Jrodna/OrthoCode/README.md

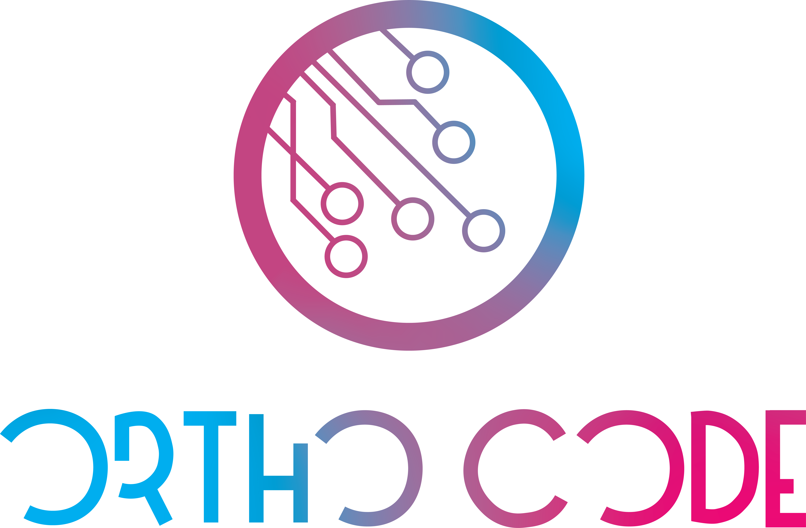
[picture p1: images/Logo_full.png]
Orthocode


Custom keyboard designed by me
The aim was to create a layout that would take advantage of what your thumbs can do to help with ergonomics.
While also keeping compatibility with the controls of most games and allowing standard keycaps to be used.

## The store is now closed
**Sold out as of 24/06/24**

If you build your own I'd love to see it, please send through photos to orthocodekb@gmail.com :)

~~There are still some units for sale, if you would like to purchase one for NZD 280 + shipping please contact me directly at orthocodekb@gmail.com
Happy to discuss doing the build for you / soldering some components before sending it out at no additional cost.~~

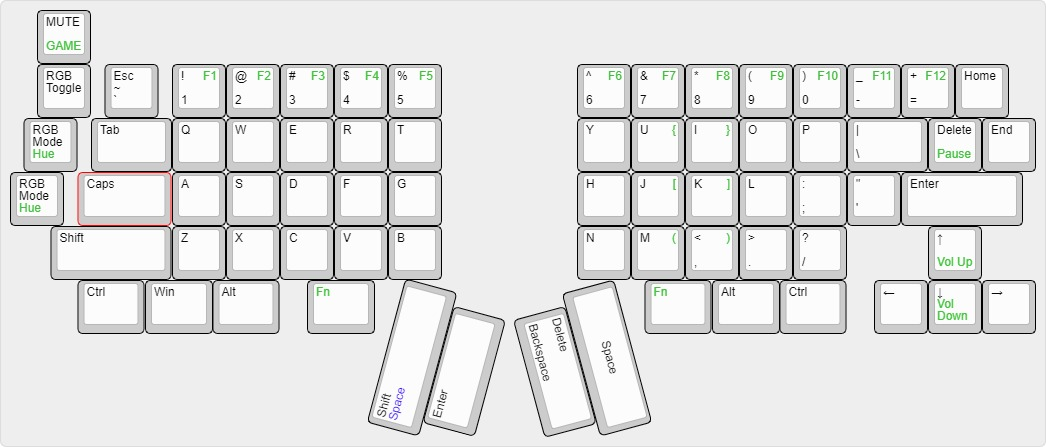
[picture p2: images/keyboard-layout.jpg]
Layout Image


# Version 1.0
- Larger footprints for resistors
- Added second plate option
- Plate now extends to edge of case
- Case updated to have even thickness either side of screws

# [Build Guide](https://docs.google.com/document/d/1nWpPh-oH03j4JtJZUHaI0wIrHX6gjucpwuYNbipHhU0/edit?usp=sharing)
# [Flashing Guide](https://docs.google.com/document/d/1nAf7OWkI6dcUZ9Cg3KUXB8WHUz0CQ5AS2SiLe1XIzos/edit?usp=sharing)

# PCB
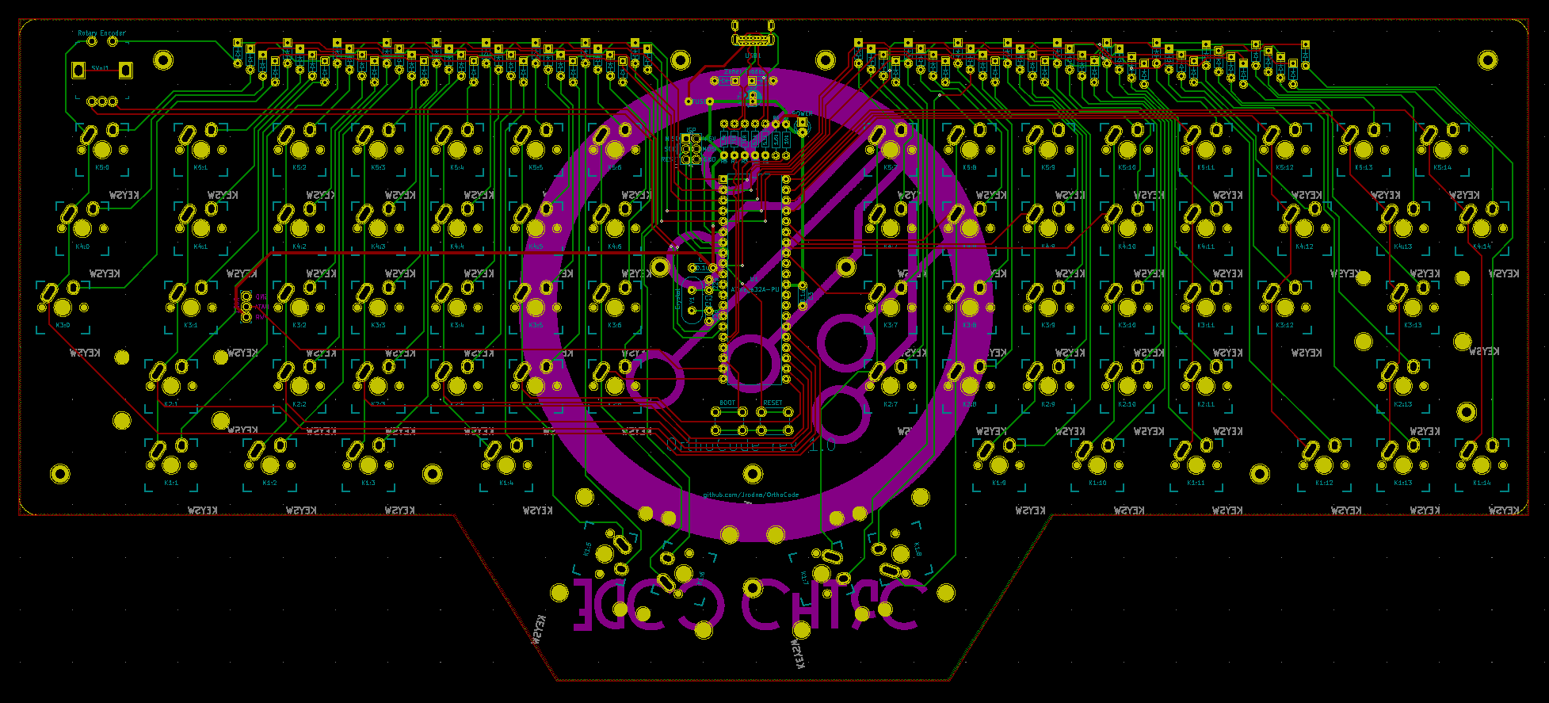
[picture p3: images/1.0 PCB.PNG]
PCB Image


# BOM
[Octopart parts list](https://octopart.com/bom-tool/VurG2dVY)

# Production Photos
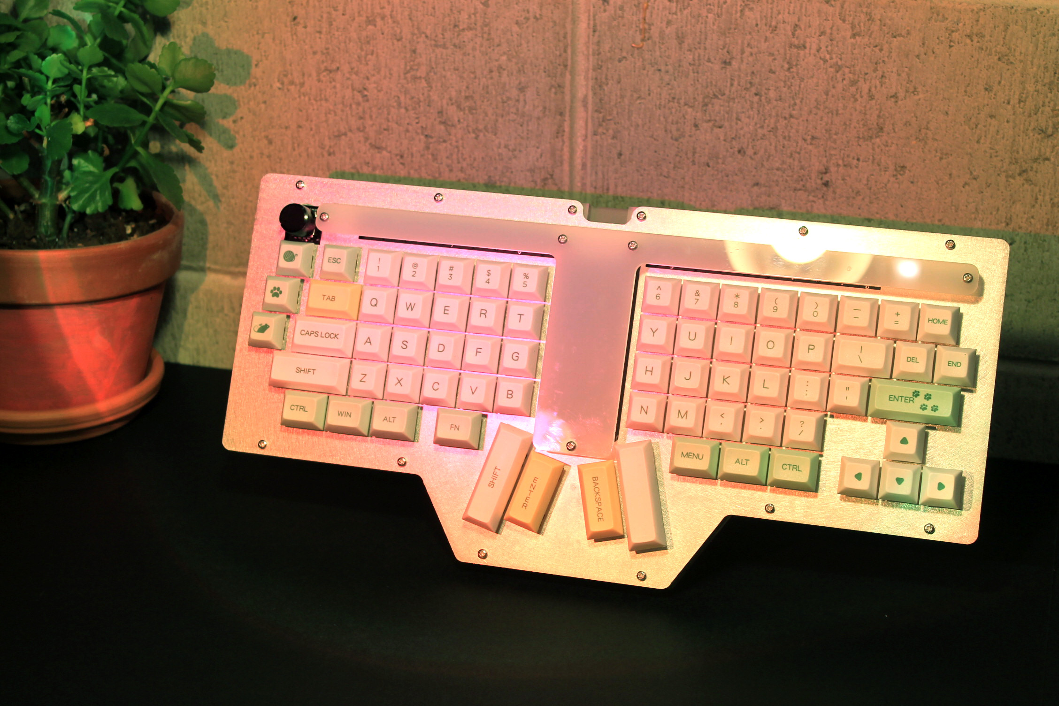
[picture p4: images/IMG_5573.JPG]

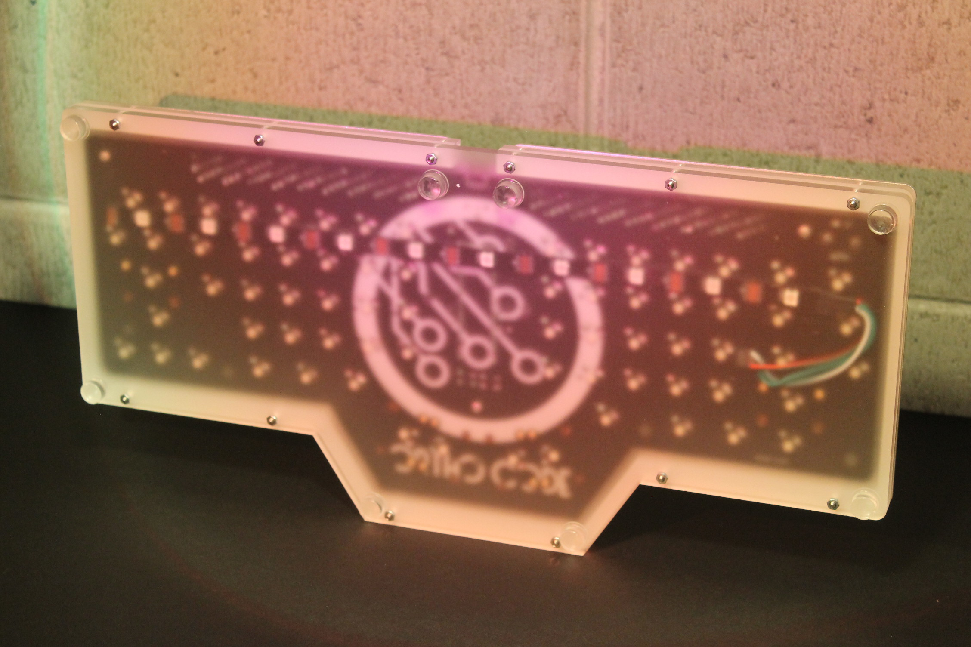
[picture p5: images/IMG_5571.JPG]

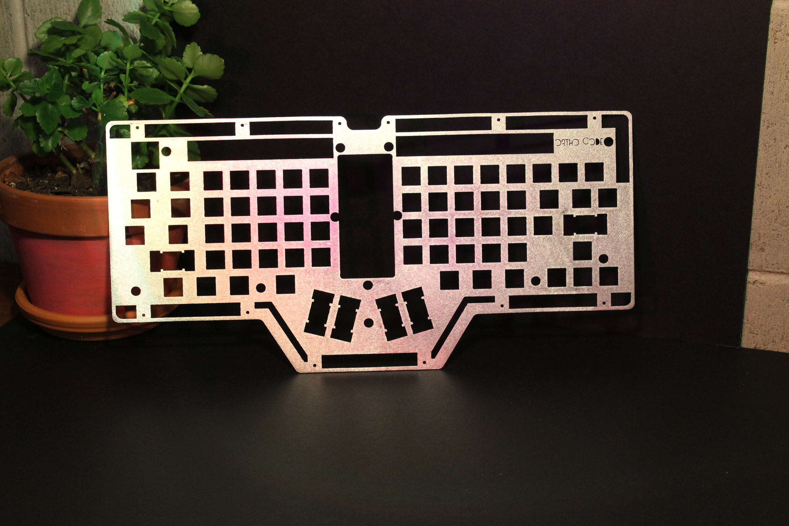
[picture p6: images/IMG_5576.png]

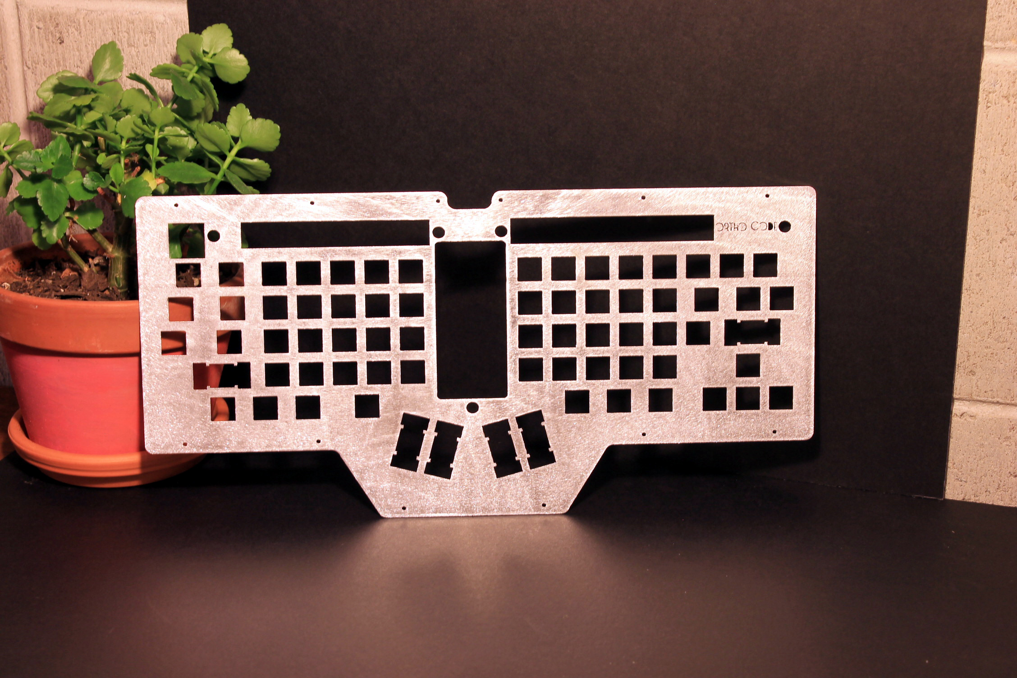
[picture p7: images/IMG_5580.JPG]

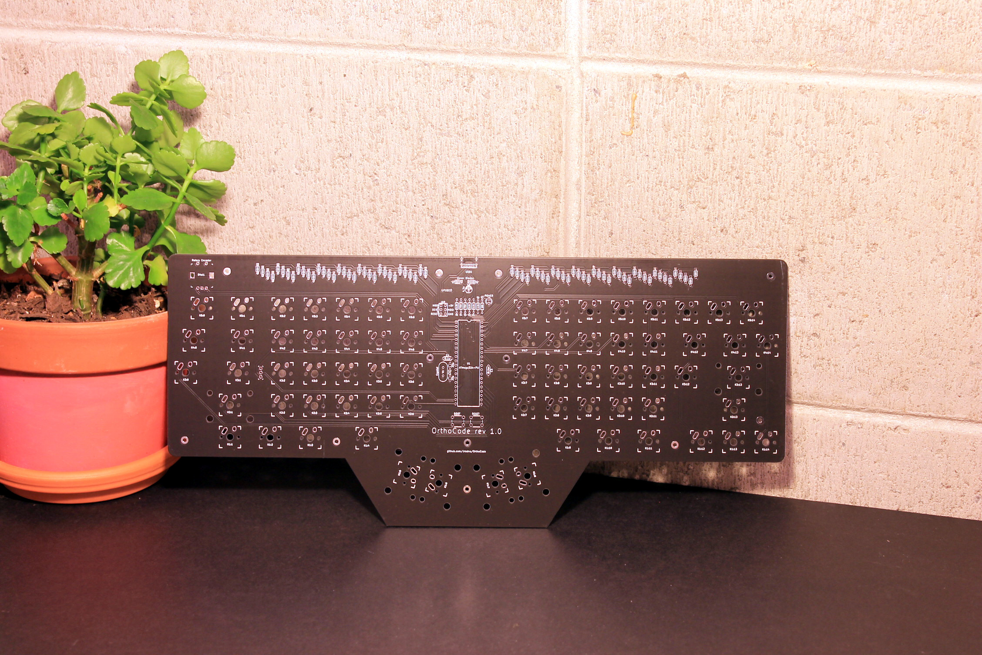
[picture p8: images/IMG_5581.JPG]

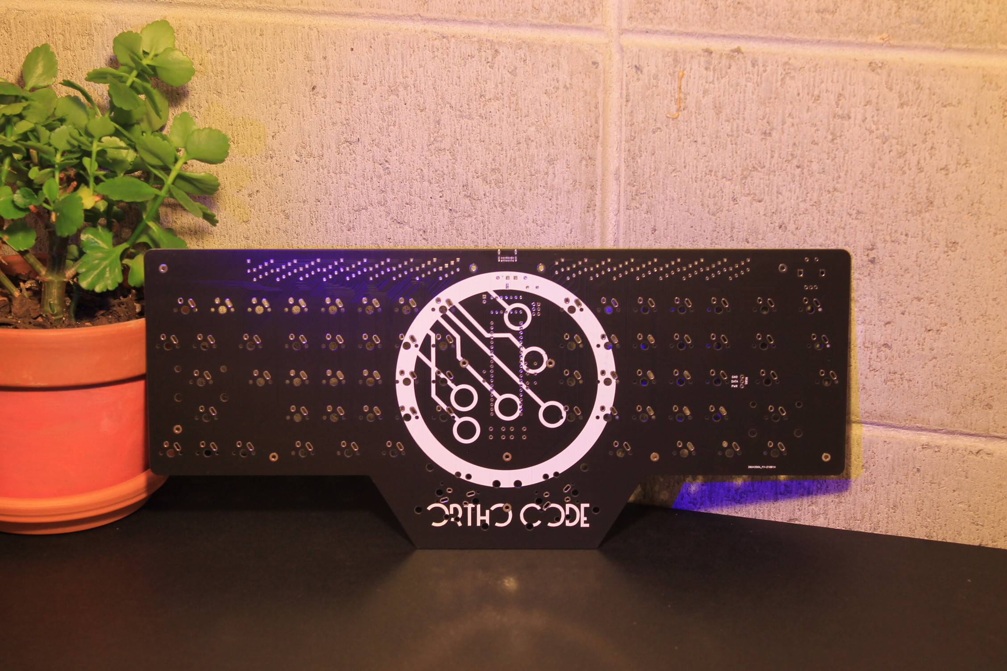
[picture p9: images/IMG_5586.JPG]

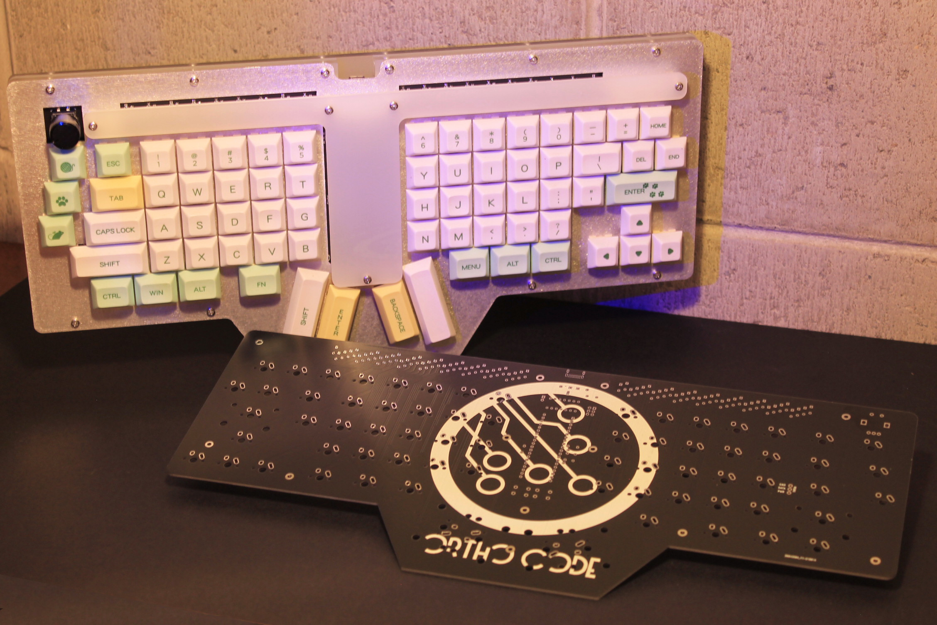
[picture p10: images/IMG_5587.JPG]

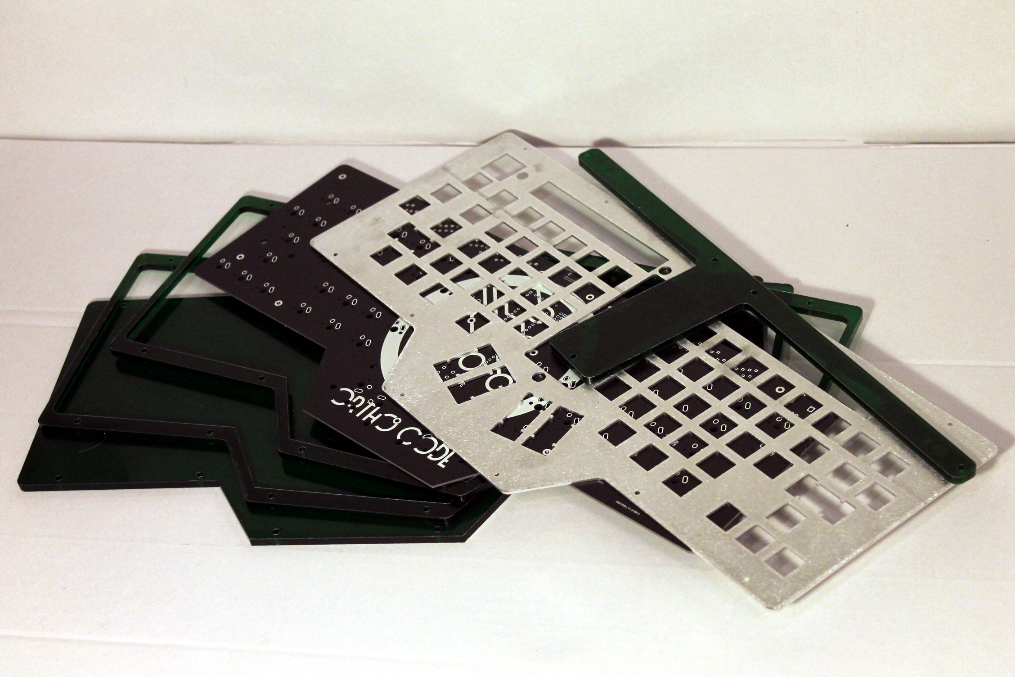
[picture p11: images/IMG_5604.JPG]


# Sound Test

video: https://www.youtube.com/embed/ZMxaZsce7TQ

Files for laser cutting at:
https://github.com/Jrodna/OrthoCode/tree/master/laserFiles

Acrylic sizes
Middle layers: any number of pieces making up 9mm in thickness (production ones were either 2x4.5mm or 6mm and 3mm)
Base layer: any thickness (production ones were either 6mm or 4.5mm)
