Jrodna/OrthoCode/images/0.jpg

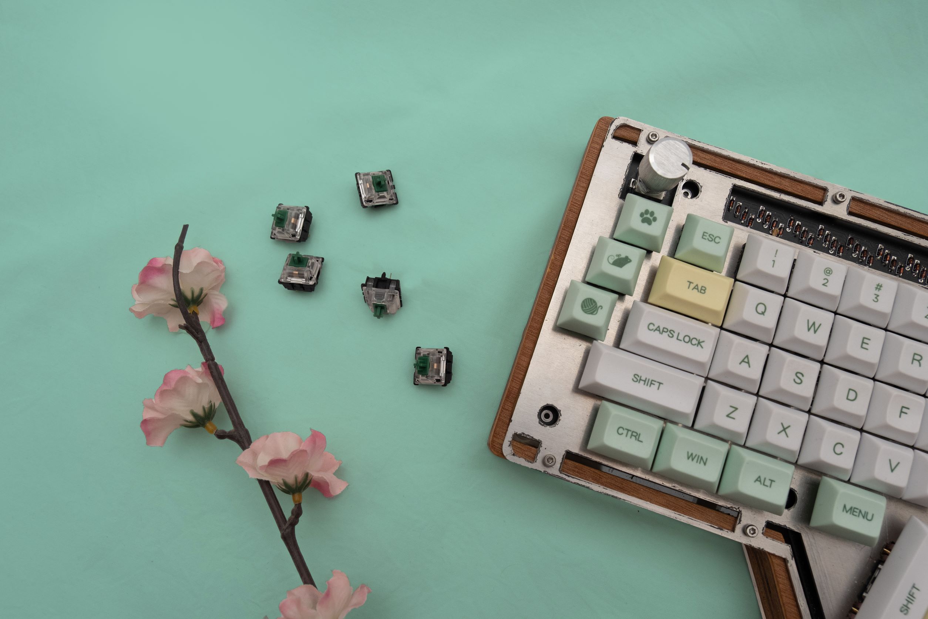
images/0.jpg
