Jrodna/OrthoCode/images/1.jpg

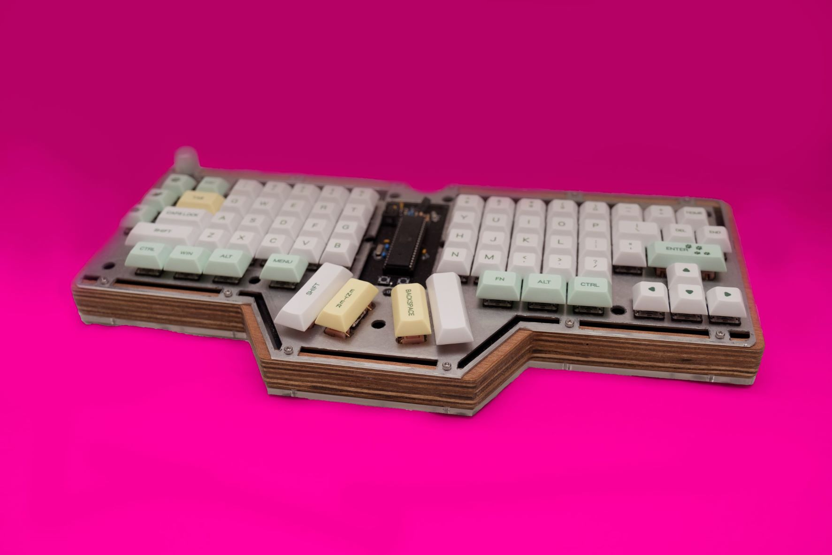
images/1.jpg
