Jrodna/OrthoCode/images/2.jpg

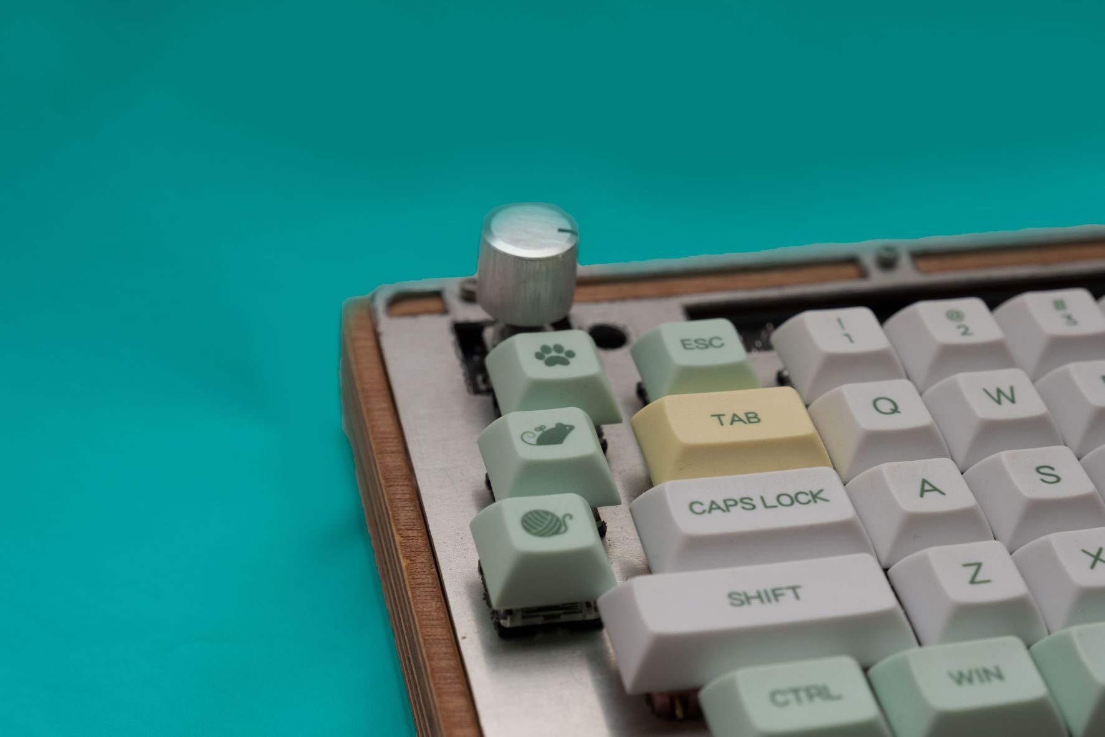
images/2.jpg
