Jrodna/OrthoCode/images/3dView.png

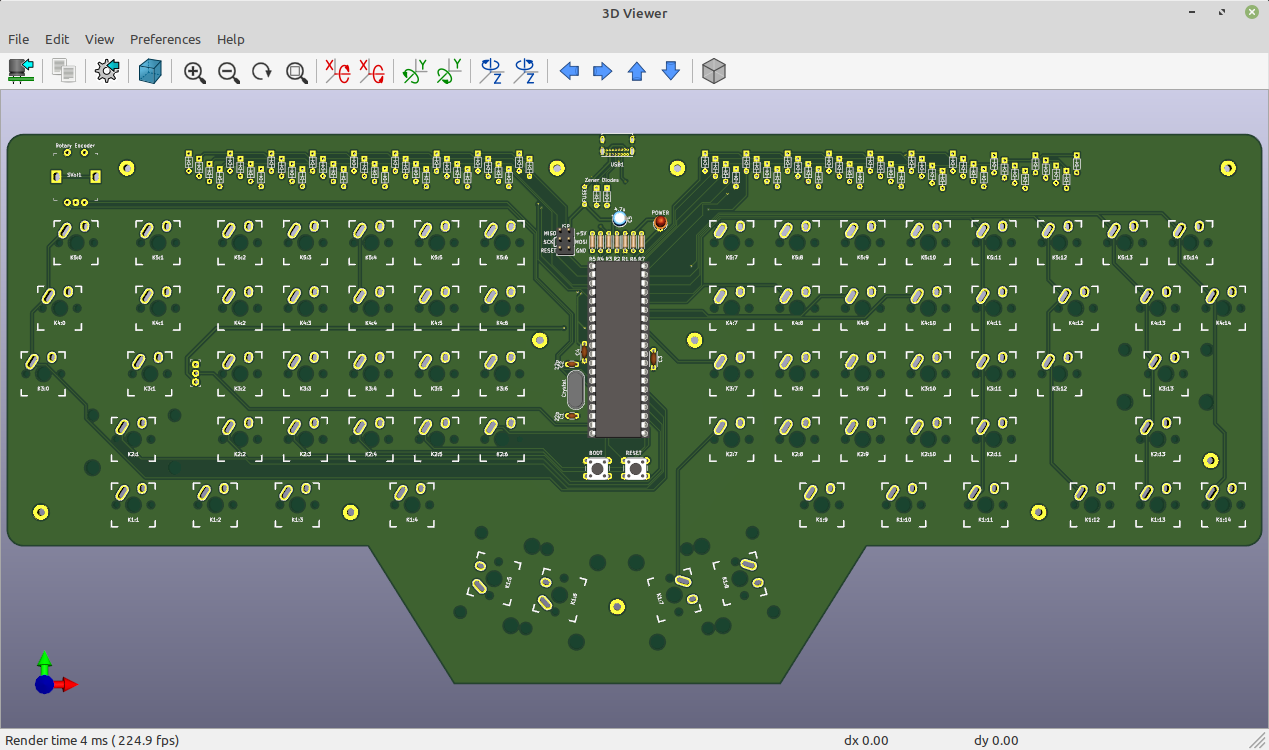
images/3dView.png
