Jrodna/OrthoCode/images/5.jpg

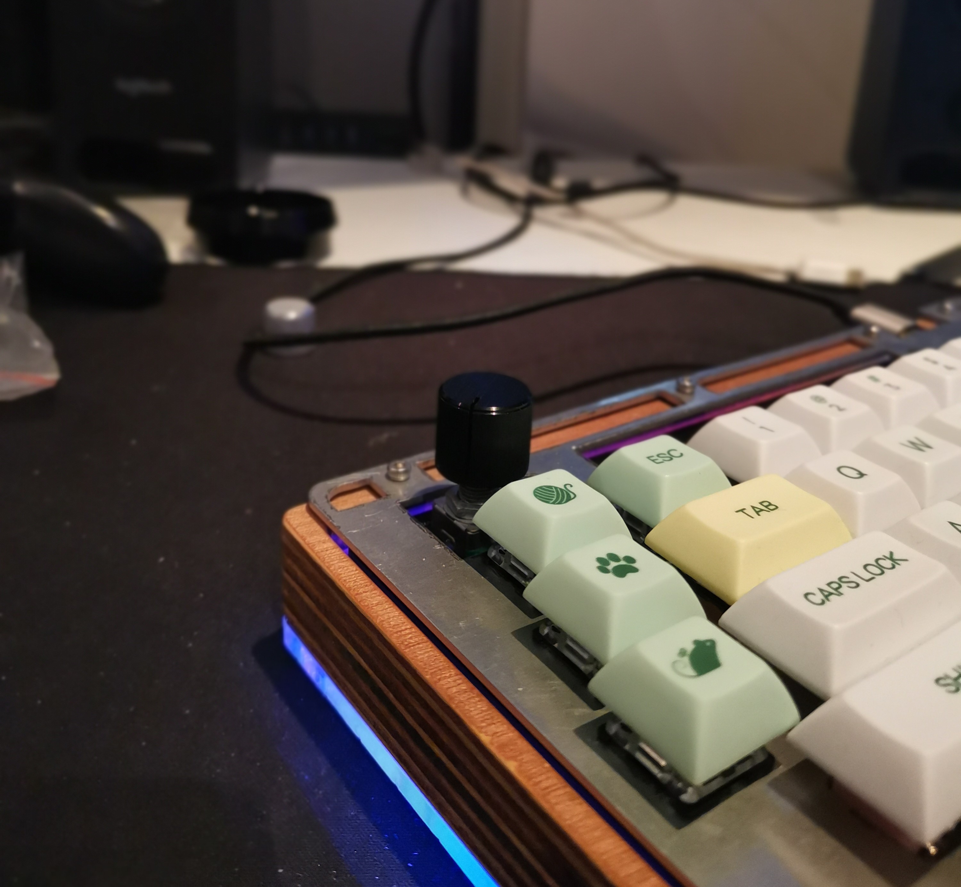
images/5.jpg
