Jrodna/OrthoCode/images/7.jpg

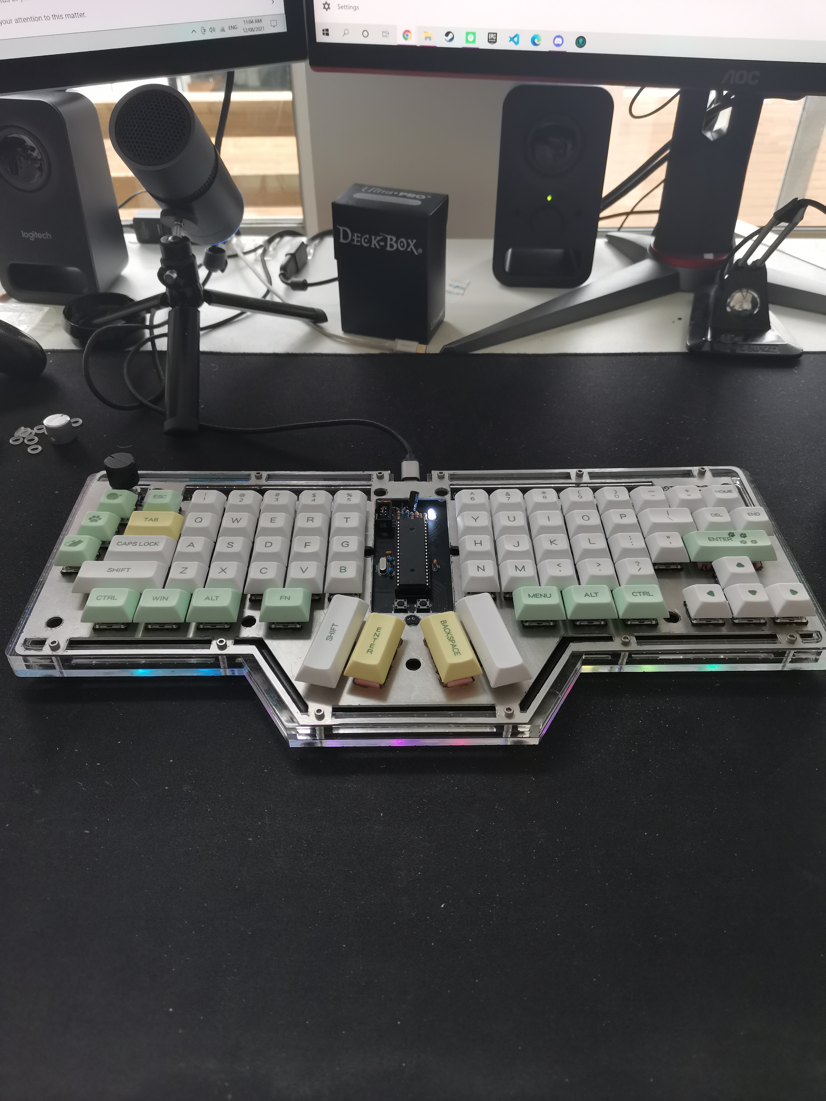
images/7.jpg
