Jrodna/OrthoCode/images/8.jpg

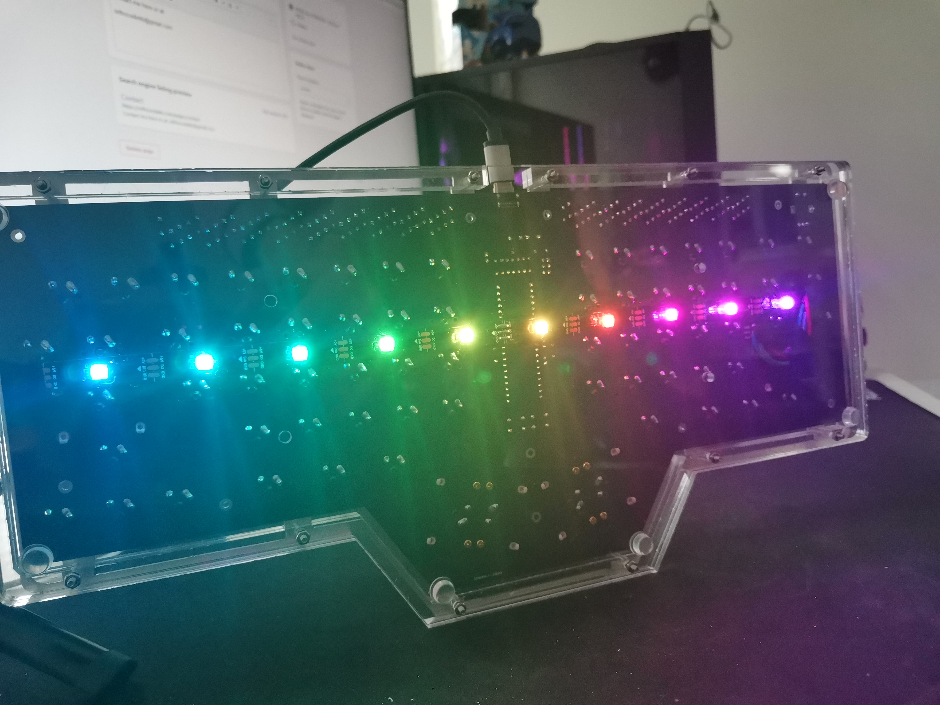
images/8.jpg
