Jrodna/OrthoCode/images/9.jpg

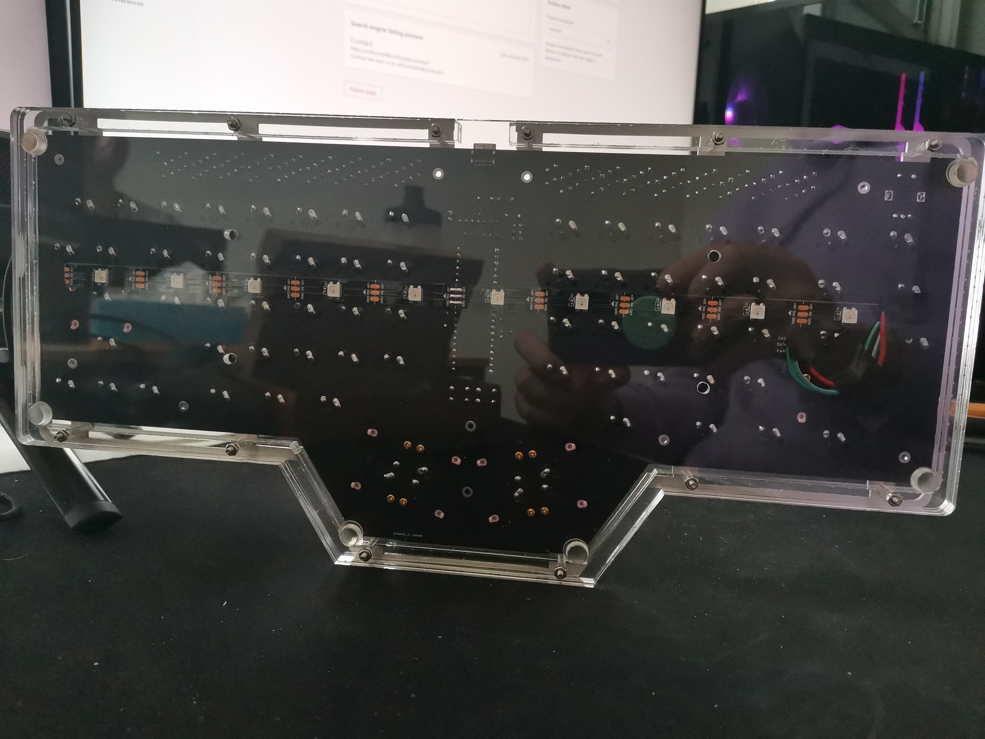
images/9.jpg
