Jrodna/OrthoCode/images/layout.png

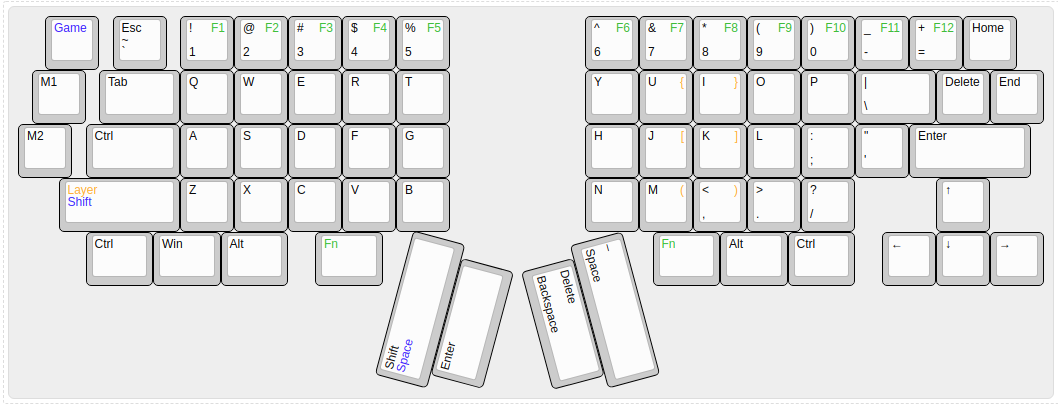
images/layout.png
