Jrodna/OrthoCode/images/PCB.png

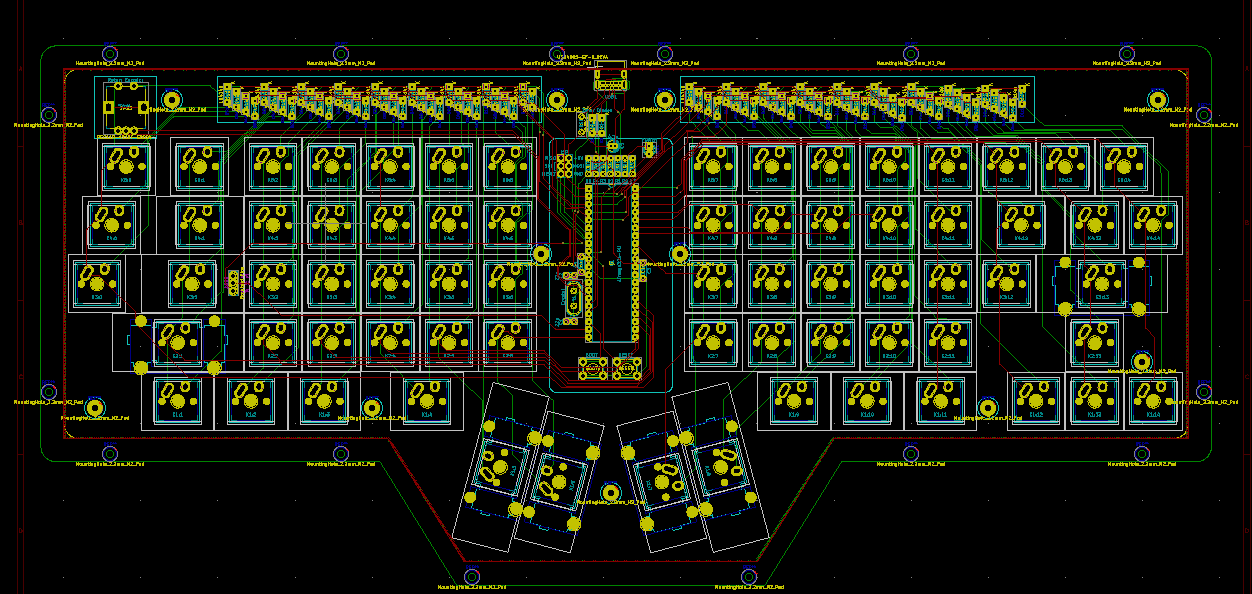
images/PCB.png
