Jrodna/OrthoCode/laserFiles/PlateWCutouts.dxf

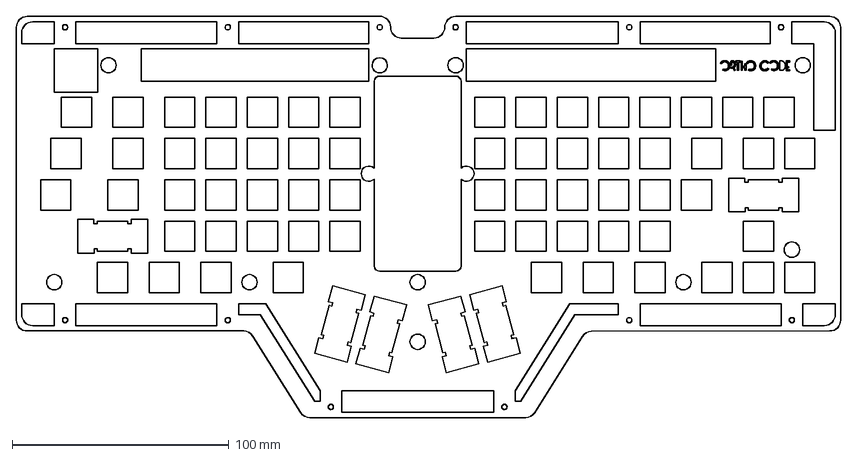
[picture p25: CAD file, 2021-08-17]
laserFiles/PlateWCutouts.dxf
380.0 x 185.1 mm
