Jrodna/OrthoCode/laserFiles/AcrylicBorder.dxf

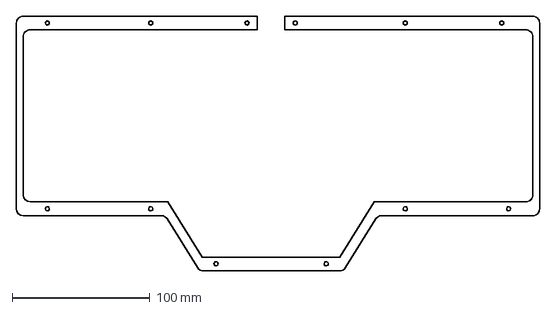
[picture p26: CAD file, 2021-08-17]
laserFiles/AcrylicBorder.dxf
380.0 x 185.1 mm
