Jrodna/OrthoCode/laserFiles/PlateNoCutouts.dxf

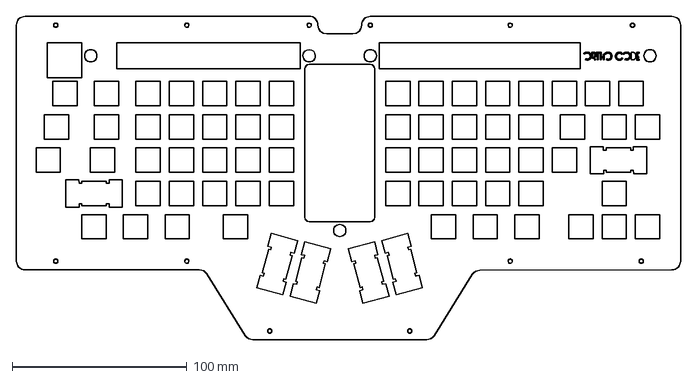
[picture p27: CAD file, 2021-08-17]
laserFiles/PlateNoCutouts.dxf
380.0 x 185.1 mm
