Jrodna/OrthoCode/laserFiles/AcrylicBase.dxf

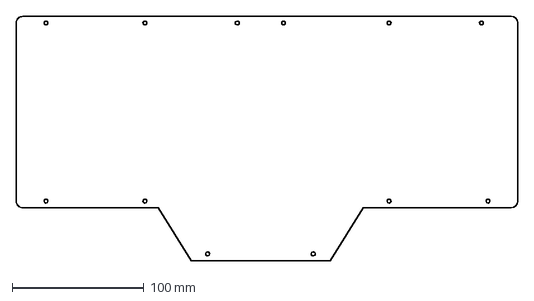
[picture p28: CAD file, 2021-08-17]
laserFiles/AcrylicBase.dxf
380.0 x 185.1 mm
