Jrodna/OrthoCode/laserFiles/AcrylicBorder+Cover.dxf

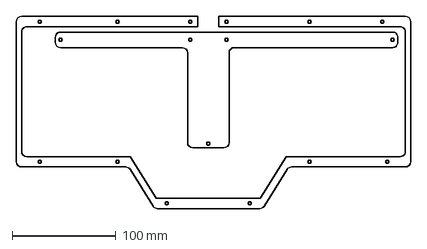
[picture p29: CAD file, 2021-08-17]
laserFiles/AcrylicBorder+Cover.dxf
380.0 x 185.1 mm
