Jrodna/OrthoCode/(commit log)

2020-08-03 pushing all files
    [orthoCode.kicad_pcb, orthoCode.sch]
2020-08-30 Added CFTKB footprints, all tht components, new matrix
    switched to all tht components including the ATMega32A.
    Added footprints from CFTKB's projects since components will be similar if not the same.
    Compressed the switch matrix.
    [orthoCode.kicad_pcb, orthoCode.sch]
2020-08-31 Added pcb file, updated diodes to come before the switches in circuit
    [orthoCode.kicad_pcb, orthoCode.sch]
2020-08-31 Flip diodes, arrange components
    [orthoCode.kicad_pcb, orthoCode.sch]
2020-09-01 Finished routing for pcb, added ground planes, outlined plate
    [orthoCode.kicad_pcb, orthoCode.sch]
2020-09-01 Added Images and files for cutting the base and plate
    [orthoCode-Base.dxf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]
2020-09-03 Update Routing, track widths widened to 0.4mm min
    Feedback from r/PrintedCircuitBoard
    [orthoCode.kicad_pcb]
2020-09-03 More routing fixes, data lines routed as differential pair, new dxfs
    [orthoCode-Base.dxf, orthoCode-Plate.dxf, orthoCode.kicad_pcb]
2020-09-03 labelled lines as differential pairs, fixed routing for data lines
    [orthoCode.kicad_pcb, orthoCode.sch]
2020-09-03 swapped around oscillator and its caps
    [orthoCode.kicad_pcb]
2020-09-04 new plate design with mounting tabs
    [orthoCode.kicad_pcb]
2020-09-05 New gerber files, widened tracks on right side diodes.
    [orthoCode-Eco2_User.dxf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]
2020-09-23 increased size of resistor footprints, new plate design
    [orthoCode-Eco2_User.dxf, orthoCode.sch, orthoCodeCase.kicad_pcb]
2020-09-29 Plate sent to laser cutters
    [#OrthocodePlate.dxf, #orthoCodeCase-Eco2_User.dxf, OrthocodePlate.dxf, orthoCode-Eco2_User.dxf, orthoCodeCase-Eco2_User0.dxf, orthoCodeCase.kicad_pcb]
2021-07-21 Added graphics to silkscreen
    [orthoCode.kicad_pcb]
2021-07-28 Added silkscreen to back, new gerber files
    [orthoCode-B_Cu.gbl, orthoCode-B_Mask.gbs, orthoCode-B_Paste.gbp, orthoCode-B_SilkS.gbo, orthoCode-Edge_Cuts.gm1, orthoCode-F_Cu.gtl, orthoCode-F_Mask.gts, orthoCode-F_Paste.gtp]
2021-08-17 Added new laser files
    [#OrthocodePlate.dxf, #orthoCodeCase-Eco2_User.dxf, AcrylicBase.dxf, AcrylicBorder+Cover.dxf, AcrylicBorder.dxf, OrthocodePlate.dxf, PlateNoCutouts.dxf, PlateWCutouts.dxf]
2021-09-14 Updated gerber and lazer files to latest
    [orthoCode-B_Cu.gbl, orthoCode-B_Mask.gbs, orthoCode-B_Paste.gbp, orthoCode-B_SilkS.gbo, orthoCode-Edge_Cuts.gm1, orthoCode-F_Cu.gtl, orthoCode-F_Mask.gts, orthoCode-F_Paste.gtp]
2021-09-21 update with BOM link
